Mm-Fazlollahpour/Multi-Range-Voltage-Controlled-Current-Sink/Report/README.md

# Technical Report

This directory contains the complete technical
documentation of the Multi-Range Voltage-Controlled
Current Sink project.

The report covers:

- System architecture and circuit design
- Linear current-sink implementation
- Boost-based high-current regulation
- Current sensing and feedback control
- LTspice circuit simulations
- Component selection and analysis
- Altium schematic and PCB design
