Mm-Fazlollahpour/Multi-Range-Voltage-Controlled-Current-Sink/Simulation/boost.asc

C1: cap; 220µ
C2: cap; 180n
C3: cap; 390n
C4: cap; 100n
D1: schottky; MBRS130L
D3: schottky; MBRS130L
L1: ind; 100µ
M1: nmos; IRF6607
R1: res; 2
R2: res; .01
R3: res; 1k
R4: res; 10k
R5: res; 1k
R6: res; 10k
R7: res; 1k
R8: res; 1k
R9: res; 1k
R10: res; 1k
R11: res; 20k
R12: res; 1000k
R13: res; 9.09k
R14: res; 2k
R16: res; 10k
R19: res; 7.6k
U1: OP07
U2: OP07
U6: OP07
U7: OP07
U8: LTC6752
V1: voltage; 0
V2: voltage; PULSE(0 5 0 .000005 .000005 1e-10 .00001 20000)
V3: voltage; 15
V4: voltage; 15
V5: voltage; PULSE(.35 1.01 0 1e-9 1e-9 30e-3 60e-3)
V6: voltage; 1.9
V7: voltage; 5
V8: voltage; 15
Named nets: 0, +15, -15, controll, point, in1, out1, out2, out3, tri
.tran .2
.ic V(out1)=0 V(out2)=0 I(L1)=0 V(out3)=0
