Mm-Fazlollahpour/Multi-Range-Voltage-Controlled-Current-Sink/Simulation/continuous.asc

M1: nmos; RHU002N06
M3: nmos; IRF7303
M4: nmos; IRF7303
M5: nmos; IRF7303
Q1: npn; 2N2222
Q2: npn; 2N2222
Q3: npn; 2N2222
R1: res; .31
R2: res; 2k
R3: res; 18k
R4: res; {Rvalue}
R5: res; {Rvalue}
R8: res; {Rvalue}
R9: res; {Rvalue}
R12: res; {Rvalue}
R13: res; {Rvalue}
R20: res; 10k
R21: res; 33
R22: res; 10k
R23: res; 10k
R24: res; 10k
R25: res; 1.2
R26: res; 10k
R27: res; 10k
R28: res; 10k
R29: res; 10k
R30: res; 10k
R31: res; 10
R32: res; 850
R33: res; {Rvalue}
R34: res; {Rvalue}
U1: OP07
U2: OP07
U3: OP07
U6: OP07
V1: voltage; 15
V2: voltage; 15
V3: voltage; 3.1
V4: voltage; 2.5
V7: voltage; 0
V8: voltage; 3.3
V9: voltage; 3.3
Named nets: 0, +15, -15, v1, v2, v3, v4, v5
.tran 10
.param Rvalue=100k
