Mm-Fazlollahpour/Multi-Range-Voltage-Controlled-Current-Sink/(list of files, drawings)

Other design files:
Hardware/current sink.PcbDoc
Hardware/current sink.SchDoc
